wearablecomputing/wearpi-py/docs/wearpi-BOM.ods

Component | Unit price (EUR) | Quantity | subtotal | Notes | Link
Raspberry Pi 5, 8GB RAM | 83.9 | 1 | 83.9 | Berrybase price | https://www.berrybase.de/en/raspberry-pi-5-8gb-ram
HiFiBerry DAC2 ADC Pro Audio Board | 75.7 | 1 | 75.7 | Reichelt price | https://www.reichelt.com/de/en/shop/product/raspberry_pi_shield_-_hifiberry_dac2_adc_pro-406716
Adafruit ADS1115 16-bit ADC - 4 channel with programmable amplifier | 16.45 | 1 | 16.45 | Berrybase price | https://www.berrybase.de/en/adafruit-ads1115-16-bit-adc-4-channel-with-programmable-amplifier
Adafruit NeoKey 1x4 QT I2C - Four mechanical key switches with NeoPixel | 10.95 | 1 | 10.95 | Berrybase price | https://www.berrybase.de/en/adafruit-neokey-1x4-qt-i2c-four-mechanical-key-switches-with-neopixel
Adafruit I2C Quad Rotary Encoder Breakout with NeoPixel | 8.25 | 1 | 8.25 | Berrybase price | https://www.berrybase.de/en/adafruit-i2c-quad-rotary-encoder-breakout-with-neopixel
SparkFun Qwiic - SHIM for Raspberry Pi | 1.7 | 1 | 1.7 |  | https://www.berrybase.de/en/sparkfun-qwiic-shim-for-raspberry-pi
380-piece nylon spacer assortment in plastic box, M2.5, black | 13.9 | 1 | 13.9 | Probably enough for 2 devices | https://www.berrybase.de/en/380-piece-nylon-spacer-assortment-in-plastic-box-m2.5-black
Adafruit Monochrome 0.91" 128x32 I2C OLED Display - STEMMA QT / Qwiic | 13.75 | 1 | 13.75 |  | https://www.berrybase.de/en/adafruit-monochrome-0.91-128x32-i2c-oled-display-stemma-qt-qwiic
SanDisk Extreme Pro microSDXC A2 UHS-I U3 V30 200MB/s memory card + adapter 64GB | 9.5 | 1 | 9.5 |  | https://www.berrybase.de/en/sandisk-extreme-pro-microsdxc-a2-uhs-i-u3-v30-200mb-s-memory-card-adapter-64gb
Proto Strip Board for Raspberry Pi | 4.11 | 1 | 4.11 |  | https://thepihut.com/products/raspberry-pi-proto-strip-board
Kailh mechanical buttons, Clicky White, 10 pieces | 7.65 | 1 | 7.65 | Enough for 2.5 devices | https://www.berrybase.de/en/kailh-mechanical-buttons-clicky-white-10-pieces
Incremental encoder, 24 detents, 24 pulses, push-button, upright, 6 x 20mm axis, PCB mounting | 2.4 | 4 | 9.6 | Need 4x for each device | https://www.berrybase.de/en/incremental-encoder-24-detents-24-pulses-push-button-upright-6-x-20mm-axis-pcb-mounting
Precision potentiometer 25 turns, horizontal, 500 kΩ | 0.31 | 4 | 1.24 | Need 4x for each device | https://www.reichelt.com/de/en/shop/product/precision_potentiometer_25_turns_horizontal_500_k_-2692
Developer boards - EasyC cable, 6cm | 0.69 | 6 | 4.14 |  | https://www.reichelt.com/de/en/shop/product/developer_boards_-_easyc_cable_6cm-378446
Developer boards - EasyC cable, 10cm | 0.85 | 3 | 2.55 |  | https://www.reichelt.com/de/en/shop/product/developer_boards_-_easyc_cable_10cm-378447
Power Bank, Li-Po, 5000 mAh, USB-C, black | 11.95 | 1 | 11.95 |  | https://www.reichelt.com/de/en/shop/product/power_bank_li-po_5000_mah_usb-c_black-269017
Sync and charging cable, USB-C -> USB-C, 0.15 m, black | 11.95 | 1 | 11.95 |  | https://www.reichelt.com/de/en/shop/product/sync_and_charging_cable_usb-c_-_usb-c_0_15_m_black-393120
Multi-Colour Micro Potentiometer Knob - Rainbow 10 pack | 8.38 | 1 | 8.38 |  | https://thepihut.com/products/multi-colour-micro-potentiometer-knob-rainbow-10-pack
Jack socket stereo, 3 pin, 3,5 mm | 1.15 | 4 | 4.6 |  | https://www.reichelt.com/de/en/shop/product/jack_socket_stereo_3_pin_3_5_mm-228173
Purple DSA keycaps for MX-compatible switches, pack of 10 | 6.55 | 1 | 6.55 | Berrybase price, pack of 10, need 4 per unit, choose your favourite colours | https://www.berrybase.de/en/detail/019234a4d40a7032ad9da319575d2b2b
Total | 290.09
