wearablecomputing/wearpi-py/hardware/wearpi-bottom-plate/wearpi-bottom-plate.stl

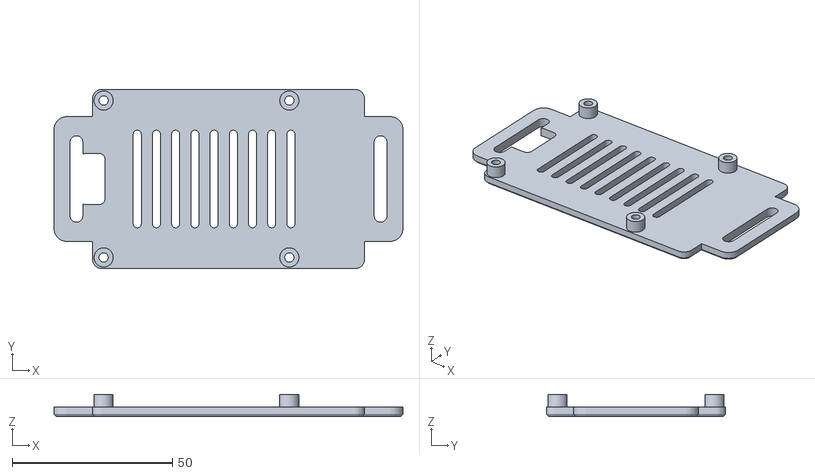
[picture p18: CAD file, 2026-11-10]
hardware/wearpi-bottom-plate/wearpi-bottom-plate.stl
109.0 x 56.0 x 7.00
