wearablecomputing/wearpi-py/images/wearpi-wiring.png

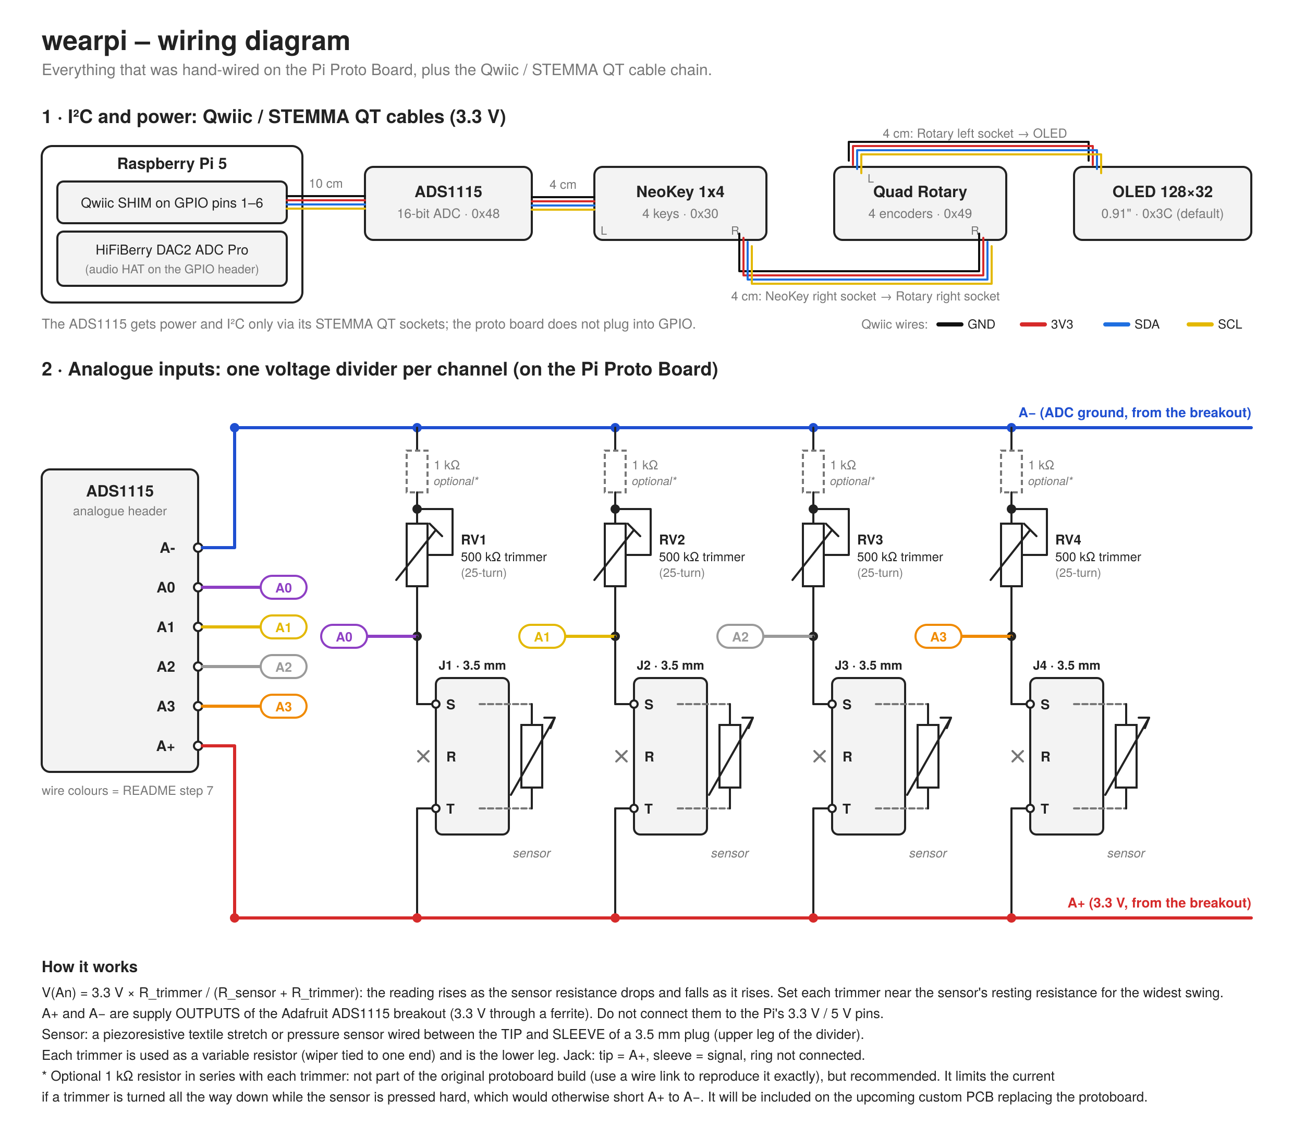
images/wearpi-wiring.png
