wearablecomputing/wearpi-py/(commit log)

2025-06-03 send osc to local print to console and order keys
2025-06-17 add separate scripts for adc and controls
2025-06-17 add adc rescaler
2025-06-18 remove buttons print
2025-06-29 add print messages
2025-06-30 add hardware list
    [wearpi-hardware.ods]
2025-10-17 add BOM
    [wearpi-BOM.ods, wearpi-hardware.ods]
2026-05-04 update BOM
    [wearpi-BOM.ods]
2026-05-28 Fix startup reliability and PD external loading
    - Remove dead seesaw code from ADC script; fix ADS1x15 v3 channel API (P0-P3 -> integers)
    - Add I2C init retry loop in controls script to handle transient bus contention on startup
    - Update startup.sh: kill stale processes before launch, add FluCoMa and MoSo abs paths, load fluid_libmanipulation
    - Fix soundfiler path in PD patch to use absolute path
    - Move superseded scripts to archive/
    [wearpi-osc-lists-adc-norm-smooth-4in.py, wearpi-osc-lists-controls.py]
2026-06-01 add filtered noise generator as input to rave (enc-but 3 to toggle)
2026-06-10 switch to timpani model
2026-11-03 add wiring diagram
2026-11-10 add MIDI watcher to keep OWL BLE-MIDI board routed into Pd
    shell/midi-watcher.sh polls every 3s and connects the OWL-BioSignals-P010
    ALSA MIDI port to Pd's MIDI input whenever both exist but are unlinked
    (e.g. after the board drops out and BlueZ reconnects it, or Pd restarts).
    Ports are matched by name since ALSA client numbers can change. Reconnects
    are logged to /tmp/midi-watcher.log.
    startup.sh launches the watcher in the background and kills any stale
    instance first.
2026-11-10 midi-watcher: poll every 1s instead of 3s
    The OWL board's ALSA MIDI port is recreated by bluetoothd roughly every
    30s, dropping the link to Pd each time. Polling every second shortens
    the resulting gap in incoming MIDI from up to 3s to about 1s.
2026-11-10 add EAVI BLE-MIDI test patch
    pd/test/eavi-bend-test.pd shows the EAVI biosignal board's 14-bit pitch
    bends: raw value (0-16383), slider, normalised 0-1 and an activity bang
    for each EAVI input, plus a messages/second counter and an optional
    print to the console. EAVI port N arrives on MIDI channel N+1, so inputs
    1-4 are routed from channels 2-5; other channels are printed.
2026-11-10 harden MIDI watcher and tighten startup kill patterns
    midi-watcher.sh:
    - warn in the log when the EAVI connects without being bonded: it then
    refuses to send MIDI and the link drops every ~30s
    - also try the port name 'bluenrg', which the EAVI reported after pairing
    startup.sh: make the pkill patterns exact (anchored python command line,
    exact process names for Pd and the watcher) so they no longer kill
    unrelated commands that merely mention these names.
2026-11-10 log Python script output and exit status to /tmp
    startup.sh starts the OSC scripts through a run_logged helper that
    appends their output (incl. tracebacks) plus timestamped start/exit
    lines to /tmp/wearpi-adc.log and /tmp/wearpi-controls.log. The exit
    line includes the signal name when a script is killed (e.g. SIGILL),
    since Python prints nothing in that case. Output is unbuffered via
    PYTHONUNBUFFERED so nothing is lost when a script dies.
    README: mention the logs in the startup section.
2026-11-10 add bottom plate
2026-11-10 add bottom plate decription
2026-11-10 survive transient I2C read errors in the OSC scripts
    A single failed I2C read (OSError [Errno 121] Remote I/O error) killed
    the ADC script after ~2h of running. Both scripts now catch OSError on
    their I2C reads, skip that sample/cycle and retry, so a glitch costs one
    sample instead of all data until restart.
    An I2CErrorReporter logs the first failure, a reminder every 5s while
    failures continue, and a summary with counts on recovery, so a flaky
    bus can't flood the log.
    Reads are done up front before any state is updated: the ADC reads all
    four channels before normalizing, and the controls script reads
    encoders, switches and NeoKey keys first (each key now read once per
    cycle instead of up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
2026-11-10 switch to isherwood model
    mono-rave.pd: nn~ encode/decode now load isherwood_pi_streaming instead
    of tympani-pi_streaming.
